Kinetic-analysis/COPD_shirt/README.md

# COPD_shirt
COPD-shirt repository for software, firmware and hardware
