Kinetic-analysis/COPD_shirt/Python/fig1.png

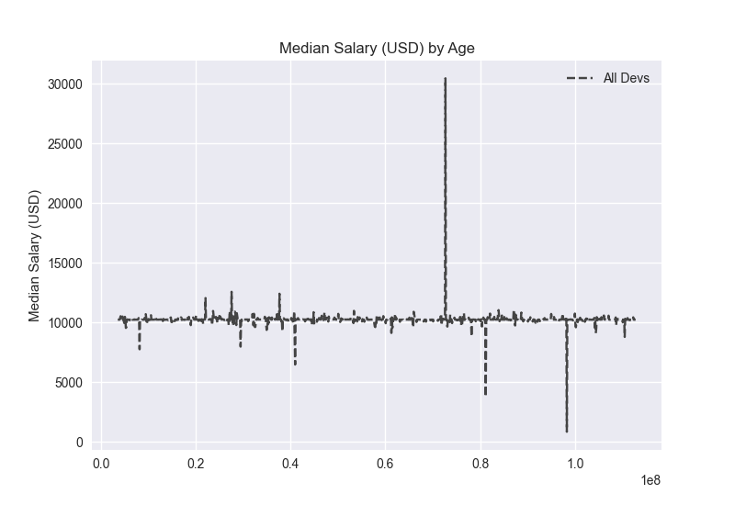
Python/fig1.png
