Kinetic-analysis/COPD_shirt/Python/fig2.png

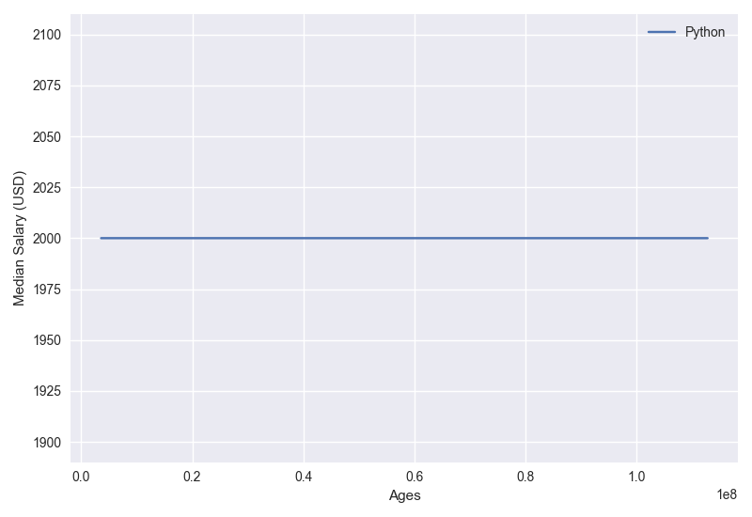
Python/fig2.png
