Kinetic-analysis/COPD_shirt/KiCad/Versie1/BestelFiles/Versie1-BOM.xlsx

 |  |  | xxxx xxxx xxxxx xxPCS BOM (Sample Bill of Materials)
Item # | *Designator | *Qty | Manufacturer | *Mfg Part # | Description / Value | *Package/Footprint | Type | Your Instructions / Notes | Digikey NO.
1 | AC1 | 1 | CEVA Technologies, Inc. | BNO080 | IMU ACCEL/GYRO/MAG I2C 32BIT | 28-LGA | SMD |  | 1888-1000-1-ND
2 | BT1 | 1 | MPD (Memory Protection Devices) | BH-18650-W | BATTERY HOLDER 18650 6" LEADS | Chassismontage | THT |  | BH-18650-W-ND
3 | C1 | 1 | Samsung Electro-Mechanics | CL10B105KP8NNNC | CAP CER 1UF 10V X7R 0603 | 0603 (1608 metrisch) | SMD |  | 1276-1946-1-ND
4 | C2,C3 | 2 | Samsung Electro-Mechanics | CL10B475KQ8NQNC | CAP CER 4.7UF 6.3V X7R 0603 | 0603 (1608 metrisch) | SMD |  | 1276-2087-1-ND
5 | C4,C6,C7,C8,C9 | 5 | Samsung Electro-Mechanics | CL10B104KB8NNNL | CAP CER 0.1UF 50V X7R 0603 | 0603 (1608 metrisch) | SMD |  | 1276-CL10B104KB8NNNLCT-ND
6 | C5 | 1 | Taiyo Yuden | JMK107ABJ106MA-T | CAP CER 10UF 6.3V X5R 0603 | 0603 (1608 metrisch) | SMD |  | 587-5869-1-ND
7 | C10,C11 | 2 | Samsung Electro-Mechanics | CL10C220JB81PNC | CAP CER 22PF 50V C0G/NP0 0603 | 0603 (1608 metrisch) | SMD |  | 1276-2226-1-ND
8 | C12,C13,C14 | 3 | Samsung Electro-Mechanics | CL10A226MPCNUBE | CAP CER 22UF 10V X5R 0603 | 0603 (1608 metrisch) | SMD |  | 1276-2868-1-ND
9 | D1 | 1 | Rohm Semiconductor | SML-E12M8WT86 | LED GREEN DIFFUSED 0603 SMD | 0603 (1608 metrisch) | SMD |  | 511-1584-1-ND
10 | D2,D3 | 2 | AVX Corporation | SD1206S040S0R5 | DIODE SCHOTTKY 40V 500MA 1206 | 1206 (3216 metrisch) | SMD |  | 478-7804-1-ND
11 | IC1 | 1 | Diodes Incorporated | AP9221SA-CC-HAC-7 | IC BATT PROT LI-ION 1CELL 6UDFN | U-DFN2030-6 (type C) | SMD |  | 31-AP9221SA-CC-HAC-7CT-ND
12 | IC2 | 1 | Renesas Electronics America Inc | ISL91107IRTNZ-T7A | IC REG BCK BST 3.3V 2A 20TQFN | 20-TQFN (3x4) | SMD |  | ISL91107IRTNZ-T7ACT-ND
13 | J1 | 1 |  |  |  | 1x04_P2.54mm | THT
14 | J2 | 1 | GCT | USB4105-GF-A | CONN RCPT USB2.0 TYPEC 5A | USB-C | THT |  | 2073-USB4105-GF-ACT-ND
15 | J3 | 1 | Amphenol ICC (FCI) | 67997-410HLF | CONN HEADER VERT 10POS 2.54MM | 2x05_P2.54mm | THT |  | 609-3243-ND
16 | J4 | 1 | Amphenol ICC (FCI) | 67997-206HLF | CONN HEADER VERT 6POS 2.54MM | 2x03_P2.54mm | THT |  | 609-3234-ND
17 | J5,J6 | 2 |  |  |  | 1x08_P2.54mm | THT
18 | J7 | 1 |  |  |  | 1x01_P2.54mm | THT
19 | J8,J9 | 2 | On Shore Technology Inc. | OSTVN02A150 | TERM BLK 2P SIDE ENT 2.54MM PCB | 1x02_P2.54mm | THT |  | ED10561-ND
20 | L1 | 1 | Murata Electronics | 1277AS-H-1R0M=P2 | FIXED IND 1UH 3.1A 45 MOHM SMD | 1210 (3225 metrisch) | SMD |  | 490-10590-1-ND
21 | LED1 | 1 | Bivar Inc. | SMTL4-RGY | LED GREEN/RED/YLW CLR 4PLCC SMD | 4-PLCC | SMD |  | 492-2173-1-ND
22 | Q1,Q2,Q3,Q4 | 4 | Diodes Incorporated | DMG2302UKQ-7 | MOSFET N-CH 20V 2.8A SOT23 T&R 3 | SOT-23 | SMD |  | 31-DMG2302UKQ-7CT-ND
23 | R1,R2,R16,R17,R19 | 5 | Vishay Dale | RCC0603100KFKEA | RCC0603 100 100K 1% ET1 E3 | 0603 (1608 metrisch) | SMD |  | 541-RCC0603100KFKEACT-ND
24 | R3,R10,R11,R13,R14,R21 | 6 | Vishay Dale | RCC060310K0FKEA | RCC0603 100 10K 1% ET1 E3 | 0603 (1608 metrisch) | SMD |  | 541-RCC060310K0FKEACT-ND
25 | R4,R5,R6,R7 | 4 | Vishay Dale | RCC0603100RFKEA | RCC0603 100 100R 1% ET1 E3 | 0603 (1608 metrisch) | SMD |  | 541-RCC0603100RFKEACT-ND
26 | R8 | 1 | TE Connectivity / Holsworthy (https://nl.mouser.com/manufacturer/te-holsworthy/) | CRGH0603F470R | RES 470 OHM 1% 1/5W 0603 | 0603 (1608 metrisch) | SMD |  | 273-KDV06FR470ETCT-ND
27 | R9 | 1 | Vishay Dale | RCC06032K00FKEA | RCC0603 100 2K0 1% ET1 E3 | 0603 (1608 metrisch) | SMD |  | 541-RCC06032K00FKEACT-ND
28 | R12 | 1 | Vishay Dale | RCC0603330RFKEA | RCC0603 100 330 1% ET1 E3 | 0603 (1608 metrisch) | SMD |  | 541-RCC0603330RFKEACT-ND
29 | R15 | 1 | Rohm Semiconductor | ESR03EZPF2701 | RES SMD 2.7K OHM 1% 1/4W 0603 | 0603 (1608 metrisch) | SMD |  | RHM2.70KADCT-ND
30 | R18,R20 | 2 | Vishay Dale | RCC06034K70FKEA | RCC0603 100 4K7 1% ET1 E3 | 0603 (1608 metrisch) | SMD |  | 541-RCC06034K70FKEACT-ND
31 | R22,R23 | 2 | Vishay Dale | RCC06032K20FKEA | RCC0603 100 2K2 1% ET1 E3 | 0603 (1608 metrisch) | SMD |  | 541-RCC06032K20FKEACT-ND
32 | R24 | 1 | Vishay Dale | RCC06031K00FKEA | RCC0603 100 1K0 1% ET1 E3 | 0603 (1608 metrisch) | SMD |  | 541-RCC06031K00FKEACT-ND
33 | R25,R26,R27 | 3 | Vishay Dale | RCS0603120RFKEA | RES SMD 120 OHM 1% 1/4W 0603 | 0603 (1608 metrisch) | SMD |  | 541-10426-1-ND
34 | S1 | 1 | Omron Electronics Inc-EMC Div | B3U-1000P | SWITCH TACTILE SPST-NO 0.05A 12V |  | SMD |  | SW1020CT-ND | X
35 | U1 | 1 | Espressif Systems | ESP32-WROOM-32E (8MB) | RX TXRX MOD WIFI TRACE ANT SMD |  | SMD |  | 1965-ESP32-WROOM-32E(8MB)CT-ND | X
36 | U2 | 1 | Microchip Technology | MCP73831T-2ATI/MC | IC BATT CONTRL LI-ION 1CELL 8DFN | 8-DFN (2x3) | SMD |  | MCP73831T-2ATI/MCCT-ND
37 | Y1 | 1 | EPSON | FC-135R 32.7680KF-AC3 | CRYSTAL 32.7680KHZ 9PF SMD | 0,126" L x 0,059" B (3,20mm x 1,50mm) | SMD |  | SER4075CT-ND
 | Pinheader 40 positions |  | Sullins Connector Solutions | PREC040SAAN-RC | CONN HEADER VERT 40POS 2.54MM |  |  |  | S1012EC-40-ND
