Kinetic-analysis/COPD_shirt/KiCad/Versie2/Component_Library/AP9221SA-CC-HAC-7/3D/AP9221SA-CC-HAC-7.stp

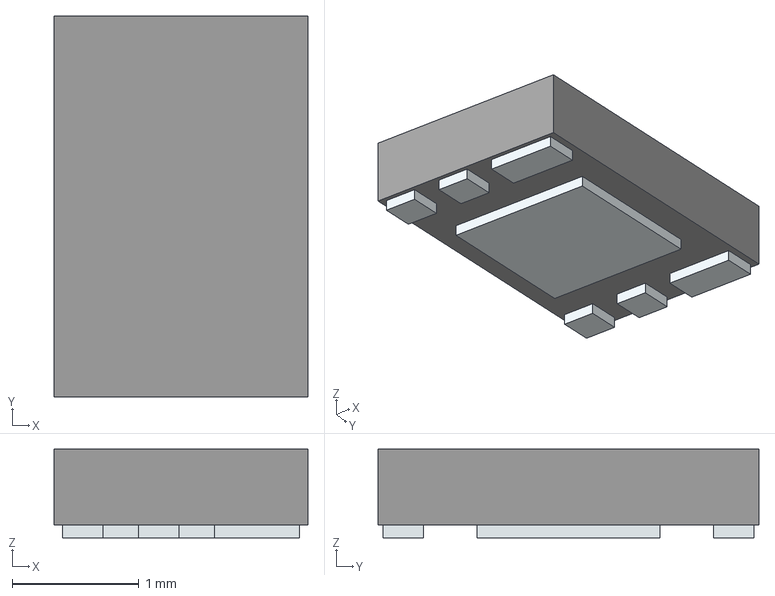
[picture p3: CAD file, 2021-03-11]
KiCad/Versie2/Component_Library/AP9221SA-CC-HAC-7/3D/AP9221SA-CC-HAC-7.stp
2.00 x 3.00 x 0.7 mm
Pins
