Kinetic-analysis/COPD_shirt/KiCad/Versie2/Component_Library/B3U-1000P/3D/B3U-1000P.stp

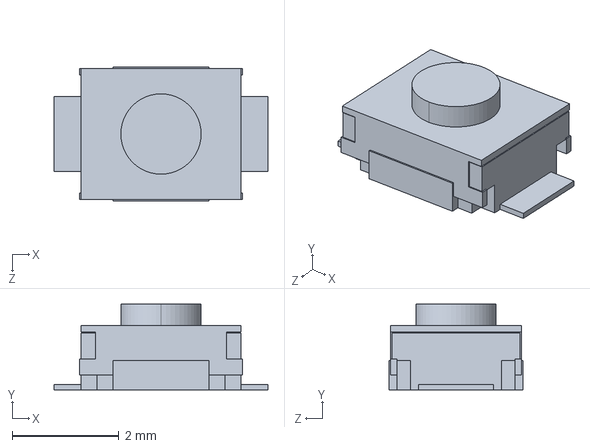
[picture p4: CAD file, 2021-03-11]
KiCad/Versie2/Component_Library/B3U-1000P/3D/B3U-1000P.stp
4.00 x 1.60 x 2.50 mm
