Kinetic-analysis/COPD_shirt/KiCad/Versie2/Component_Library/BNO080/3D/BNO080.stp

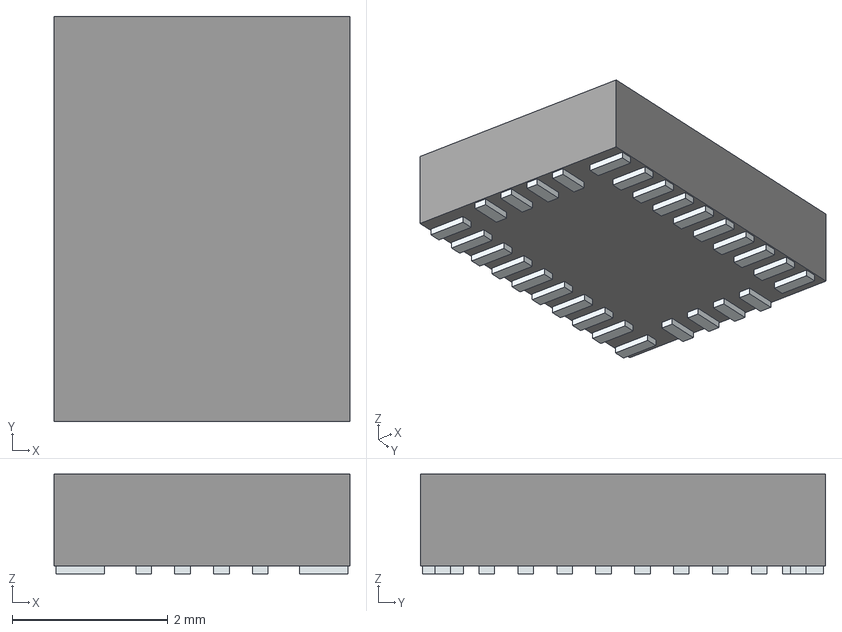
[picture p5: CAD file, 2021-03-11]
KiCad/Versie2/Component_Library/BNO080/3D/BNO080.stp
3.80 x 5.20 x 1.28 mm
Pins
