Kinetic-analysis/COPD_shirt/KiCad/Versie2/Component_Library/ICM-20948/3D/ICM-20948.stp

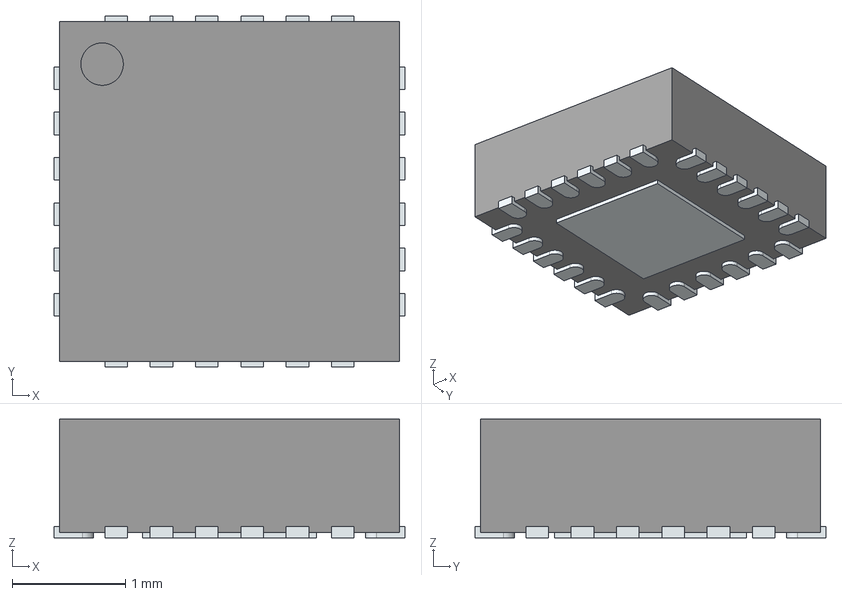
[picture p6: CAD file, 2021-04-14]
KiCad/Versie2/Component_Library/ICM-20948/3D/ICM-20948.stp
3.10 x 3.10 x 1.05 mm
ThermalPin
PinsArrayLR
PinsArrayTB
