Kinetic-analysis/COPD_shirt/KiCad/Versie2/Component_Library/SMTL4-RGY/3D/SMTL4-RGY.stp

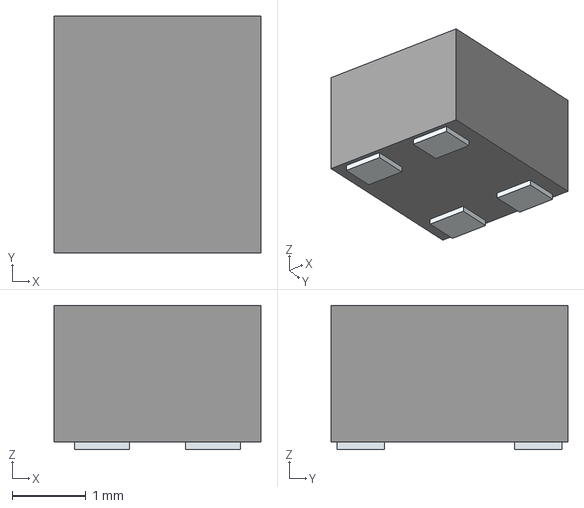
[picture p7: CAD file, 2021-03-11]
KiCad/Versie2/Component_Library/SMTL4-RGY/3D/SMTL4-RGY.stp
2.80 x 3.20 x 1.95 mm
Pins
