Kinetic-analysis/COPD_shirt/KiCad/Versie2/Component_Library/ISL91107IRTNZ-T7A/3D/ISL91107IRTNZ-T7A.stp

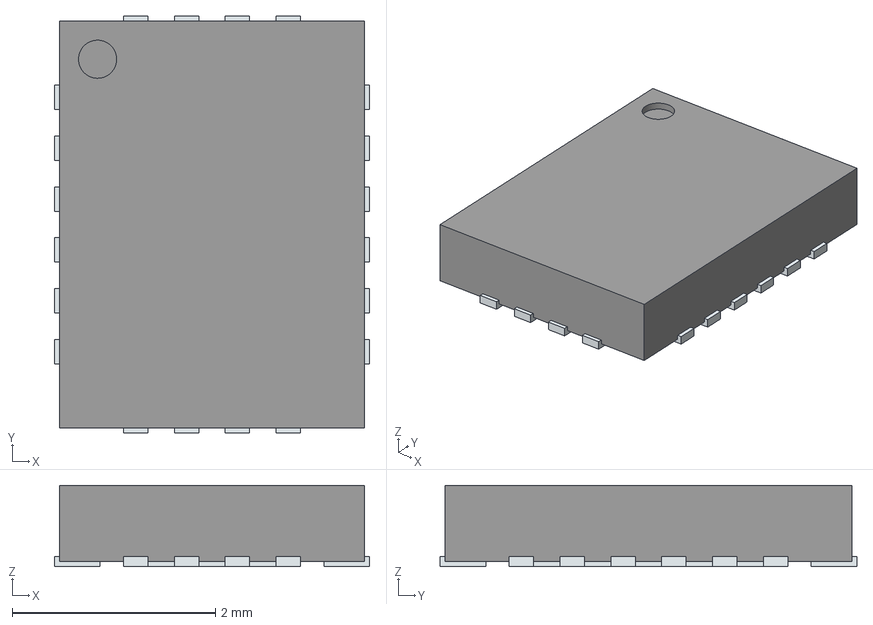
[picture p8: CAD file, 2021-03-11]
KiCad/Versie2/Component_Library/ISL91107IRTNZ-T7A/3D/ISL91107IRTNZ-T7A.stp
3.10 x 4.10 x 0.8 mm
ThermalPin
PinsArrayLR
PinsArrayTB
