Kinetic-analysis/COPD_shirt/(list of files, cad)

Other CAD files:
KiCad/Versie2/Component_Library/AP9221SA-CC-HAC-7/3D/AP9221SA-CC-HAC-7.stl
KiCad/Versie2/Component_Library/AP9221SA-CC-HAC-7/Allegro/ap9211saanhac7.psm
KiCad/Versie2/Component_Library/AP9221SA-CC-HAC-7/DEHDL/ap9221sa_cc_hac_7/chips/chips.prt
KiCad/Versie2/Component_Library/B3U-1000P/Allegro/b3u-1000p.psm
KiCad/Versie2/Component_Library/B3U-1000P/DEHDL/b3u_1000p/chips/chips.prt
KiCad/Versie2/Component_Library/BNO080/3D/BNO080.stl
KiCad/Versie2/Component_Library/BNO080/Allegro/bno080.psm
KiCad/Versie2/Component_Library/BNO080/DEHDL/bno080/chips/chips.prt
KiCad/Versie2/Component_Library/ICM-20948/3D/ICM-20948.stl
KiCad/Versie2/Component_Library/ICM-20948/Allegro/qfn40p300x300x105-25n-d.psm
KiCad/Versie2/Component_Library/ICM-20948/DEHDL/icm_20948/chips/chips.prt
KiCad/Versie2/Component_Library/ISL91107IRTNZ-T7A/3D/ISL91107IRTNZ-T7A.stl
KiCad/Versie2/Component_Library/ISL91107IRTNZ-T7A/Allegro/qfn50p300x400x80-21n.psm
KiCad/Versie2/Component_Library/ISL91107IRTNZ-T7A/DEHDL/isl91107irtnz_t7a/chips/chips.prt
KiCad/Versie2/Component_Library/PTS645SL43SMTR92_LFS/Allegro/pts645sl43smtr92lfs.psm
KiCad/Versie2/Component_Library/PTS645SL43SMTR92_LFS/DEHDL/pts645sl43smtr92_lfs/chips/chips.prt
KiCad/Versie2/Component_Library/SMTL4-RGY/3D/SMTL4-RGY.stl
KiCad/Versie2/Component_Library/SMTL4-RGY/Allegro/smtl4rgy.psm
KiCad/Versie2/Component_Library/SMTL4-RGY/DEHDL/smtl4_rgy/chips/chips.prt
