Kinetic-analysis/COPD_shirt/KiCad/Versie1/Versie1.pdf

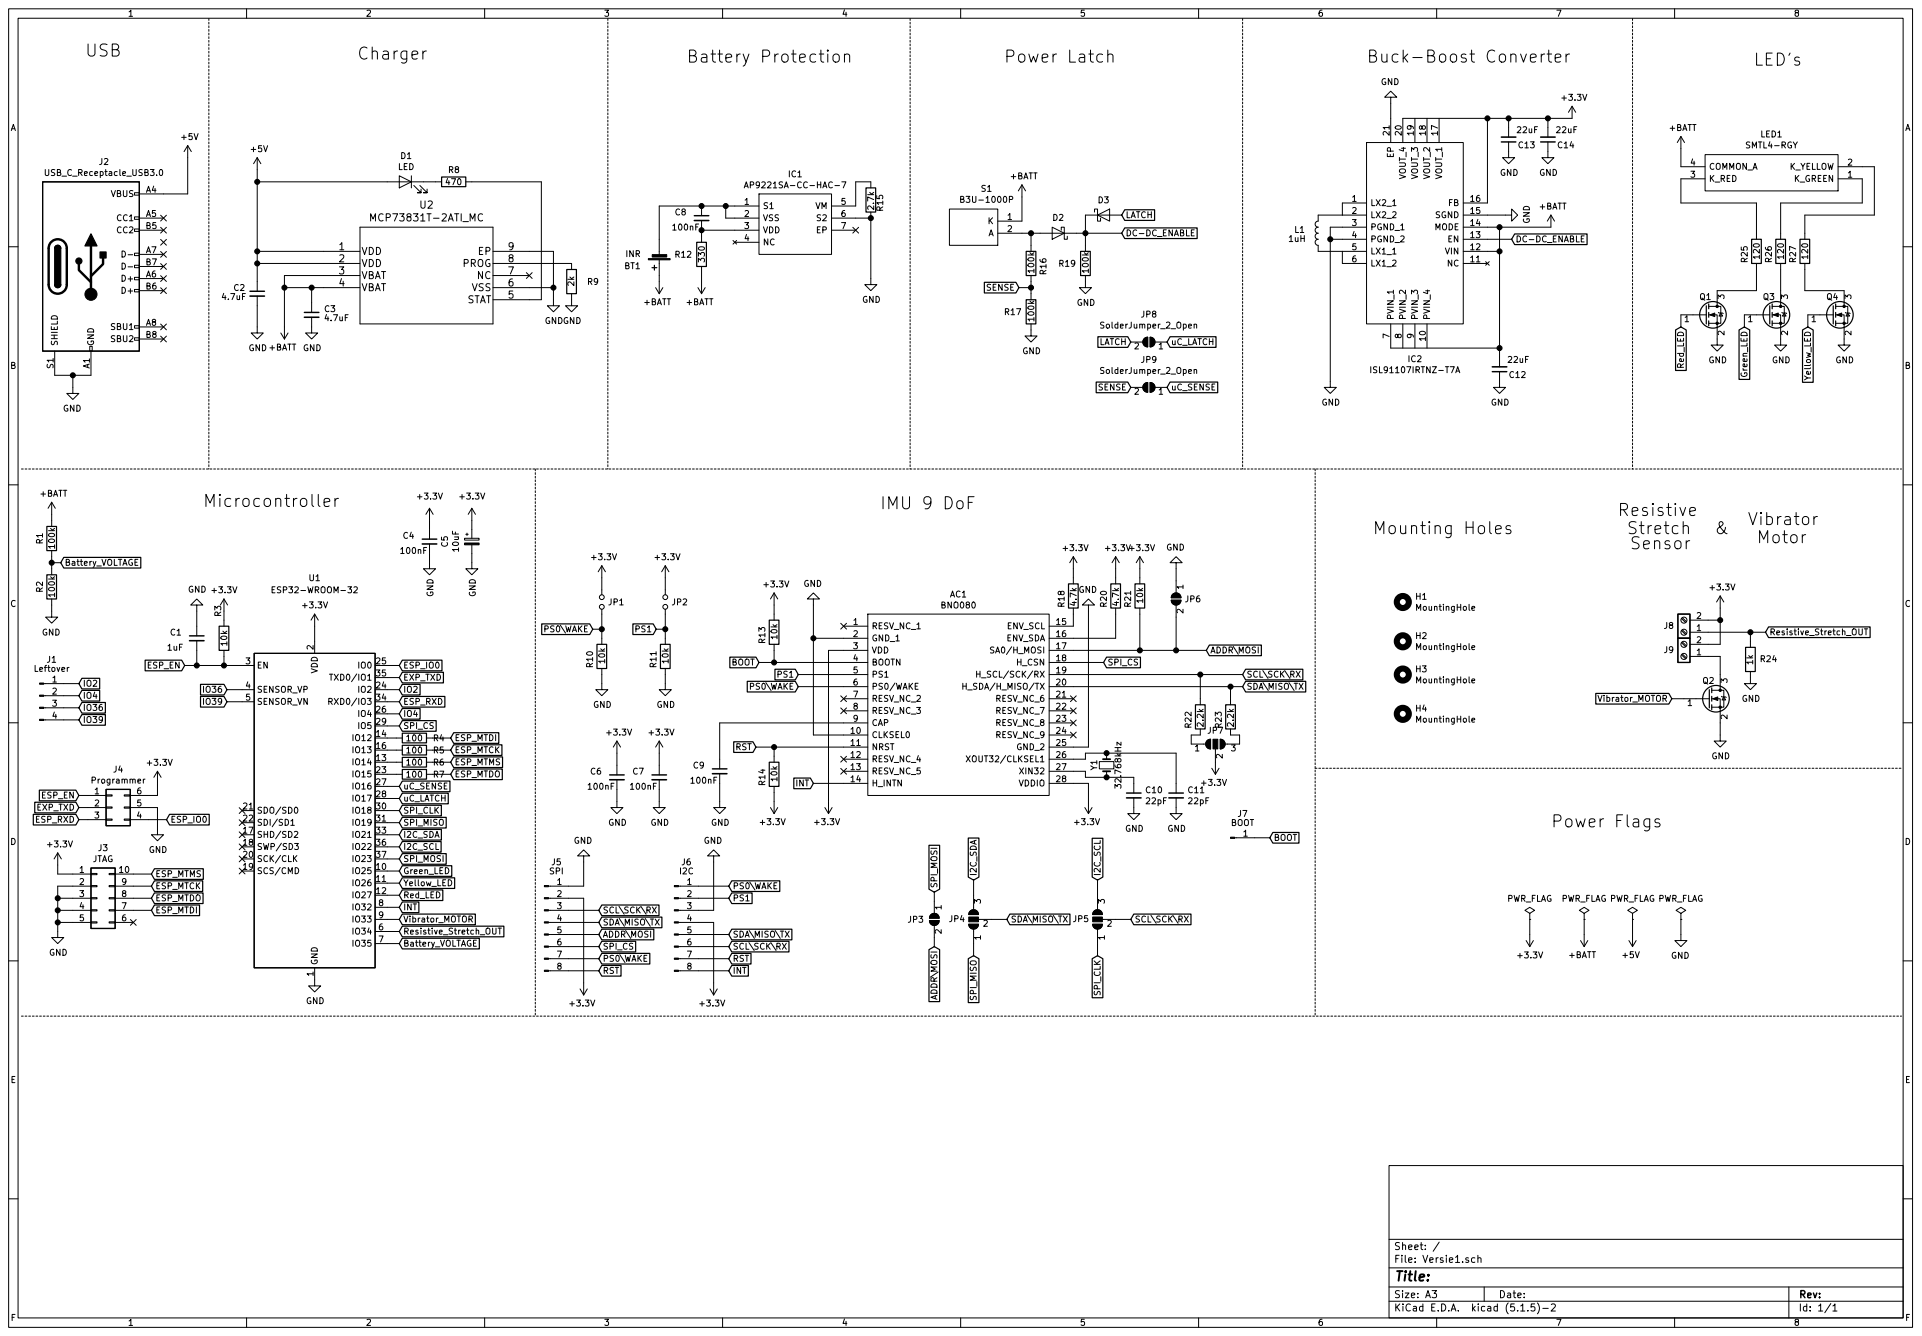
[picture p40: page 1]

2 SCK/CLK 20 SDO/SD0 21 SDI/SD1 22

Id: 1/1 Title: File: Versie1.sch Sheet: /
