Kinetic-analysis/COPD_shirt/LTSpice/NE555.asc

C1: cap; 3n
C2: cap; 10n
C4: cap; 10n
C5: cap; 0.5n
C6: cap; 2.5n
R1: res; 1000k
R2: res; 10k
R3: res; 1000k
R4: res; 10k
R6: res; 50k
U1: NE555
U2: NE555
V1: voltage; 3.3
V2: voltage; 3.3
Named nets: 0, Frequency_OUT, Frequency_OUT2
.tran 0.1
