Kinetic-analysis/COPD_shirt/LTSpice/Level_Shifter.asc

M1: nmos; Si7102DN
M2: nmos; Si7102DN
R1: res; 2.2k
R2: res; 2.2k
R3: res; 2.2k
R4: res; 2.2k
V1: voltage; 3.3
V2: voltage; PULSE(0 10 0 10n 10n 1m 2m)
V3: voltage; 10
V4: voltage; PULSE(0 3.3 0 1n 1n 1m 2m)
Named nets: 0, BLOK, 3.3V, 5V, BLOK2
.tran 0.01
