Kinetic-analysis/COPD_shirt/LTSpice/Relaxation Oscillator.asc

C1: cap; 2n
C2: cap; 5n
C4: cap; 2n
R4: res; 10000k
R5: res; 10k
R6: res; 500k
R7: res; 500k
R8: res; 500k
R9: res; 500k
R10: res; 10k
R12: res; 1000k
U1: LM339
V1: voltage; 5
V2: voltage; -15
V3: voltage; PULSE(0 3.3 6m 1n 1n 50m 100m)
Named nets: 0, 3.3V, -3.3V, +3.3V
.tran 1
