Kinetic-analysis/COPD_shirt/LTSpice/Power Latch.asc

D1: schottky; 1N5818
D2: schottky; 1N5818
M1: pmos; AO6407
R1: res; 10k
R2: res; 100k
R3: res; 100k
R4: res; 100k
R5: res; 100k
V1: voltage; 3.7
V2: voltage; PULSE(0 3.3 251m 0 0 2m 2m)
V3: voltage; PULSE(5 0 250m 1n 1n 1m 249m 2)
Named nets: 0, ENABLE, IN, Latch, Sense, Button
.tran 1
