Kinetic-analysis/COPD_shirt/KiCad/Versie2/Versie2.kicad_pcb

## KiCad design KiCad/Versie2/Versie2.kicad_pcb (2021-06-02)

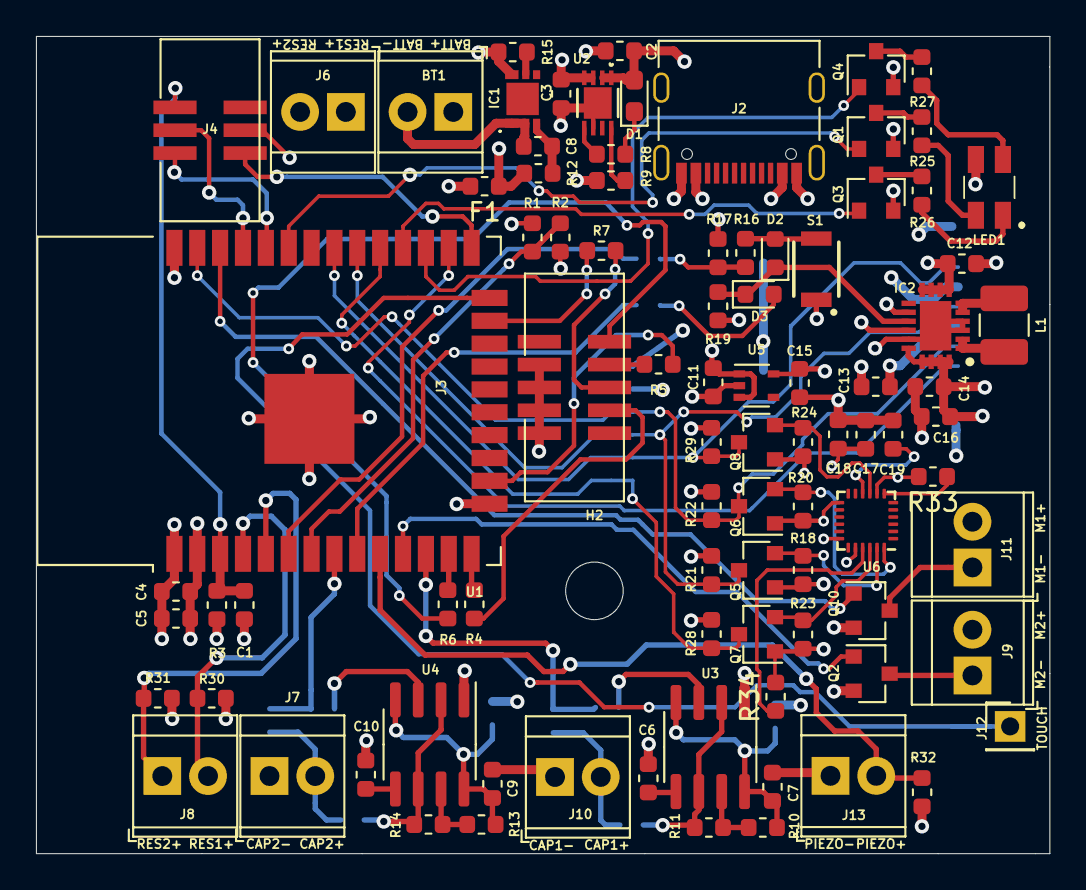
[picture p41: board Versie2.kicad_pcb from above]

Board: 4 copper layers, 56.3 x 45.4 mm, 102 parts (0 on the bottom side), 76 nets.

Parts:
BT1: INR; TerminalBlock_TE_282834-2_1x02_P2.54mm_Horizontal
C1, C11, C15, C17: 1uF; C_0603_1608Metric
C2, C3: 4.7uF; C_0603_1608Metric
C4, C7, C8, C9, C16, C18, C19: 100nF; C_0603_1608Metric
C5: 10uF; C_0603_1608Metric
C6, C10: 10nF; C_0603_1608Metric
C12, C13, C14: 22uF; C_0603_1608Metric
D1: LED; LED_0603_1608Metric_Pad1.05x0.95mm_HandSolder
D2, D3: SD1206S040S0R5; D_0603_1608Metric
F1: Polyfuse_Small; Fuse_0603_1608Metric
H2: MountingHole; MountingHole_3.2mm_M3
IC1: AP9221SA-CC-HAC-7; AP9211SAANHAC7
IC2: ISL91107IRTNZ-T7A
J1: Micro_SD_Card_Det; microSD_HC_Molex_104031-0811
J2: USB_C_Receptacle_USB3.0; USB_C_Receptacle_Palconn_UTC16-G
J3: JTAG; Pin_Header_2x5_1.27mm_CONN
J4: Programmer; Pin_Header_2x3_1.27mm_CONN
J5: Conn_01x06_Male; IMU_Testpins
J6, J7, J8, J9, J10, J11, J13: Screw_Terminal_01x02; TerminalBlock_TE_282834-2_1x02_P2.54mm_Horizontal
J12: Conn_01x01_Male; PinHeader_1x01_P2.54mm_Vertical
JP1, JP2, JP3, JP4, JP5, JP6, JP7, JP8, JP9, JP10: SolderJumper_2_Open; SolderJumper-2_P1.3mm_Open_Pad1.0x1.5mm
L1: 1uH; L_1210_3225Metric_Pad1.42x2.65mm_HandSolder
LED1: SMTL4-RGY; SMTL4RGY
Q1, Q2, Q3, Q4, Q5, Q6, Q7, Q8, Q10: Q_NMOS_GSD; SOT-23
R1, R2, R16, R17, R19: 100k; R_0603_1608Metric
R3, R10, R13, R32: 10k; R_0603_1608Metric
R4, R5, R6, R7: 100; R_0603_1608Metric
R8: 470; R_0603_1608Metric
R9: 2k; R_0603_1608Metric
R11, R14: 180k; R_0603_1608Metric
R12: 330; R_0603_1608Metric
R15: 2.7k; R_0603_1608Metric
R18, R20, R21, R22, R23, R24, R28, R29, R33, R34: 2.2k; R_0603_1608Metric
R25, R26, R27: 120; R_0603_1608Metric
R30, R31: 1k; R_0603_1608Metric
S1: B3U-1000P
U1: ESP32-WROOM-32
U2: MCP73831T-2ATI_MC; MCP73831T-2ATI&slash_MC
U3, U4: NE555DR; SOIC-8_3.9x4.9mm_P1.27mm
U5: MIC5366-1.8YC5-TR; SOT-353_SC-70-5
U6: ICM-20948; InvenSense_QFN-24_3x3mm_P0.4mm

Connections:
+1V8: C15.1, C17.1, C18.1, Q5.1, Q6.1, Q7.1, Q8.1, R18.1, R20.1, R23.1, R24.1, R33.2, R34.2, U5.5, U6.8, U6.13
+3V3: C4.1, C5.1, C11.2, C13.2, C14.2, C16.1, IC2.16, IC2.17, IC2.18, IC2.19, IC2.20, J1.4, J5.5, J6.1, J6.2, J9.2, J11.2, JP1.1, JP4.1, R3.1, R21.1, R22.1, R28.1, R29.1, U1.2, U5.1, U5.3
+5V: C2.1, D1.2, J2.A4, J2.A9, J2.B4, J2.B9, U2.1, U2.2
+BATT: C12.2, F1.2, IC2.7, IC2.8, IC2.9, IC2.10, IC2.12, IC2.14, LED1.4, R1.1, S1.1
Batt_Before_Fuse: BT1.1, C3.1, F1.1, R12.2, U2.3, U2.4
Battery_VOLTAGE: R1.2, R2.1, U1.7
Capacitive_Stretch1: J10.2, JP3.2, JP7.1
Capacitive_Stretch1_OUT: JP2.2, JP7.2, U1.12
Capacitive_Stretch2: J7.2, JP6.2, JP10.1
Capacitive_Stretch2_OUT: JP5.2, JP10.2, U1.8
DC-DC_ENABLE: D2.1, D3.1, IC2.13, R19.1
ESP_EN: C1.2, J4.1, R3.2, U1.3
ESP_IMU_CS: J5.1, Q7.3, R28.2, U1.29
ESP_IO0: J4.4, U1.25
ESP_MTCK: J3.9, R5.2
ESP_MTDI: J3.7, R4.2
ESP_MTDO: J3.8, R7.2
ESP_MTMS: J3.10, R6.2
ESP_RXD: J4.3, U1.34
ESP_SD_CS: J1.2, U1.26
ESP_SPI_CLK: J1.5, J5.3, Q5.3, R21.2, U1.30
ESP_SPI_MISO: J1.7, J5.2, Q8.3, R29.2, U1.31
ESP_SPI_MOSI: J1.3, J5.4, Q6.3, R22.2, U1.37
ESP_TXD: J4.2, U1.35
GND: C1.1, C2.2, C3.2, C4.2, C5.2, C6.2, C7.2, C9.2, C10.2, C11.1, C12.1, C13.1, C14.1, C15.2, C16.2, C17.2, C18.2, C19.2, IC1.6, IC2.3, IC2.4, IC2.15, IC2.21, J1.6, J1.11, J2.A1, J2.A12, J2.B1, J2.B12, J2.S1, J3.2, J3.3, J3.4, J3.5, J4.5, J5.6, J7.1, J10.1, J13.1, Q1.2, Q2.2, Q3.2, Q4.2, Q10.2, R2.2, R9.2, R15.2, R17.2, R19.2, R30.2, R31.1, R32.1, U1.1, U1.15, U1.38, U1.39, U2.6, U2.9, U3.1, U4.1, U5.2, U6.18, U6.20
Green_LED: Q3.1, U1.28
IMU_CLK: Q5.2, R18.2, U6.23
IMU_CS: Q7.2, R23.2, U6.22
IMU_MISO: Q8.2, R24.2, U6.9
IMU_MOSI: Q6.2, R20.2, U6.24
LATCH: D3.2, JP8.2
unnamed: BT1.2, C8.1, IC1.1, IC1.2
unnamed: C6.1, U3.5
unnamed: C7.1, JP1.2, R10.1, U3.4, U3.8
unnamed: C8.2, IC1.3, R12.1
unnamed: C9.1, JP4.2, R13.1, U4.4, U4.8
unnamed: C10.1, U4.5
unnamed: C19.1, U6.10
unnamed: D1.1, R8.1
unnamed: D2.2, R16.1, S1.2
unnamed: IC1.5, R15.1
unnamed: IC2.1, IC2.2, L1.2
unnamed: IC2.5, IC2.6, L1.1
unnamed: J9.1, Q2.3
unnamed: J11.1, Q10.3
unnamed: JP2.1, U3.3
unnamed: JP3.1, R11.2, U3.2, U3.6
unnamed: JP5.1, U4.3
unnamed: JP6.1, R14.2, U4.2, U4.6
unnamed: LED1.1, R26.1
unnamed: LED1.2, R27.1
unnamed: LED1.3, R25.1
unnamed: Q1.3, R25.2
unnamed: Q3.3, R26.2
unnamed: Q4.3, R27.2
unnamed: R4.1, U1.14
unnamed: R5.1, U1.16
unnamed: R6.1, U1.13
unnamed: R7.1, U1.23
unnamed: R8.2, U2.5
unnamed: R9.1, U2.8
unnamed: R10.2, R11.1, U3.7
unnamed: R13.2, R14.1, U4.7
unnamed: R33.1, U6.7
unnamed: R34.1, U6.21
Piezo_Speaker: J13.2, R32.2, U1.10
Red_LED: Q1.1, U1.33
Resistive_Stretch1: J8.2, R30.1, U1.4
Resistive_Stretch2: J8.1, R31.2, U1.5
SENSE: JP9.2, R16.2, R17.1
Touch_Pad: J12.1, U1.24
Vibrator_MOTOR1: Q10.1, U1.36
Vibrator_MOTOR2: Q2.1, U1.11
Yellow_LED: Q4.1, U1.27
uC_LATCH: JP8.1, U1.9
uC_SENSE: JP9.1, U1.6
