Kinetic-analysis/COPD_shirt/Arduino/FrequencyMeter/FrequencyMeter.ino

const byte        interruptPin = 23;              // Assign the interrupt pin
volatile uint64_t StartValue = 0;                 // First interrupt value
volatile uint64_t PeriodCount;                    // period in counts 
volatile uint64_t Counter;                    // period in counts 
volatile uint64_t totalCounter;                    // period in counts 
volatile uint64_t finalCounter;                    // period in counts
volatile uint64_t LoopCount;                    // period in counts  
float             Freq;                           // frequency
float eindCounter;

hw_timer_t * timer = NULL;                        // pointer to a variable of type hw_timer_t

//=======================================
void IRAM_ATTR handleInterrupt()
{
  uint64_t TempVal = timerRead(timer);            // value of timer at interrupt
  PeriodCount = TempVal - StartValue;             // period count between rising edges
  StartValue = TempVal;                           // puts latest reading as start for next calculation
  Counter = PeriodCount;
}

//======================================
void setup()
{
  Serial.begin(115200);
  pinMode(interruptPin, INPUT);                                       // sets pin as input
  
  attachInterrupt(interruptPin, handleInterrupt, FALLING);            // attaches pin to interrupt on Falling Edge
  timer = timerBegin(0, 2, true);                                     // configure timer 
  // 0 = first timer
  // 2 is prescaler so 80 MHZ divided by 2 = 40 MHZ signal
  // true - counts up
  timerStart(timer);                                                  // starts the timer
}

void loop()
{
  Freq = 40000000.00 / PeriodCount;                                  // calculate frequency 
  eindCounter = Counter;
  Serial.println(Freq, 0);
  delay(250);
}
