Kinetic-analysis/COPD_shirt/(commit log)

2021-02-26 KiCad project aangemaakt
    [Versie1.kicad_pcb, Versie1.sch]
2021-02-26 Charger+Microcontroller+DC/DC schakeling
2021-03-01 KiCad schakeling aangepast + LTSpice Power Latch simulatie
    [Versie1.sch]
2021-03-11 PCB Versie 1
    [Versie1.kicad_pcb, Versie1.sch]
2021-03-12 H2, C13, C14 aangepast
    [Versie1.kicad_pcb]
2021-03-12 5x6cm PCB en silkscreen update
    [Versie1.kicad_pcb]
2021-03-15 BOM Lijst
    [Versie1-BOM.xlsx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]
2021-03-29 IMU Footprint + Solder Jumper Power Latch
    [Versie1-B_Cu.gbr, Versie1-B_Mask.gbr, Versie1-B_Paste.gbr, Versie1-B_SilkS.gbr, Versie1-Edge_Cuts.gbr, Versie1-F_Cu.gbr, Versie1-F_Mask.gbr, Versie1-F_Paste.gbr]
2021-03-30 Arduino code voor CapStretch en LTSpice relaxation oscillator simulatie
    [Versie1-BOM.xlsx]
2021-04-05 Cap Stretch workspace fix
    [tp_read_main.c]
2021-04-05 Revert "Cap Stretch workspace fix"
    This reverts commit ae097c9e7e08dc22c9a6af32dc6dd1f8fa1f5098.
    [tp_read_main.c]
2021-04-05 TCP ESP32 + Python
2021-04-08 Arduino Frequency Meter
2021-04-08 Interrupt+Timer Eclipse (CapSensor)
2021-04-10 PWM_Motor example
2021-04-11 KiCad Library fix
    [AP9221SA-CC-HAC-7.stl, AP9221SA-CC-HAC-7.stp, B3U-1000P.stp, BNO080.stl, BNO080.stp, EDI2CAP.CFG, ISL91107IRTNZ-T7A.stl, ISL91107IRTNZ-T7A.stp]
2021-04-12 Integratie Battery+LED+ResistiveStretch
2021-04-12 Power Latch
2021-04-13 KiCad begin versie2
    [AP9221SA-CC-HAC-7.stl, AP9221SA-CC-HAC-7.stp, B3U-1000P.stp, BNO080.stl, BNO080.stp, EDI2CAP.CFG, ISL91107IRTNZ-T7A.stl, ISL91107IRTNZ-T7A.stp]
2021-04-13 KiCad Cap Stretch schakeling
    [Versie2.sch]
2021-04-14 KiCad IMU
    [EDI2CAP.CFG, ICM-20948.stl, ICM-20948.stp, Versie2.sch, chips.prt, qfn40p300x300x105-25n-d.psm]
2021-04-14 KiCad Buzzer + SD Card
    [Versie2.sch]
2021-04-15 KiCad Schakeling update
    [Versie2.sch]
2021-04-15 KiCad PCB IC Layout
    [Versie2.kicad_pcb, Versie2.sch]
2021-04-16 KiCad Footprints adjusted
    [Versie2.sch]
2021-04-16 KiCad Plaatsing componenten
    [Versie2.sch]
2021-04-16 KiCad New layout
    [Versie2.kicad_pcb, Versie2.sch]
2021-04-17 KiCad PCB Versie 2 af
    [Versie2.kicad_pcb, Versie2.sch]
2021-04-18 BOM en bestel files aangepast
    [Versie2-BOM.xlsx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]
2021-04-25 IMU Sensor write + read register
2021-04-26 NE555 LTSpice equivalent sensor
2021-04-27 IMU Sensor accelero + gyro
2021-04-29 IMU Accelero+Gyro werkend
2021-04-29 Magneto werkend
2021-04-29 IMU accelero+gyro+magneto samen werkend
2021-05-05 CapacitiveTouch Tests aanpassingen
2021-05-07 PCB Versie 2 integratie, sensor, imu, battery management, motor, tcp client
2021-05-10 SD_Card arduino ESP32
2021-06-02 Deelsystemen ingedeeld met C en H files
    [Versie2-B_Mask.gbr, Versie2-B_Paste.gbr, Versie2-B_SilkS.gbr, Versie2-Edge_Cuts.gbr, Versie2-F_Mask.gbr, Versie2-F_Paste.gbr, Versie2-F_SilkS.gbr, Versie2-GND.gbr]
2021-06-08 SD met IMU initialisatie
2021-06-09 Wi-Fi data versturen en data visualisatie update
    [data.csv]
2021-06-18 NE555 + Wi-Fi werkend
    [data.csv]
